SeaGuy/raindance/docs/raindance-spec.docx

# RainDance Sprinkler Controller

This controller will replace the existing broken Intermatic electromechanical sprinkler clock system (240 VAC) using off-the-shelf components.

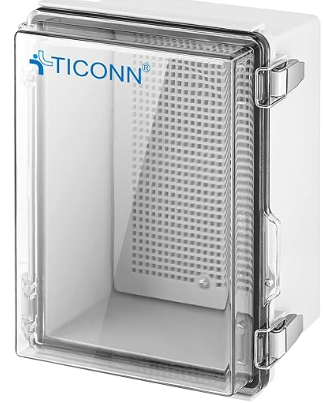
[picture p6: figure]
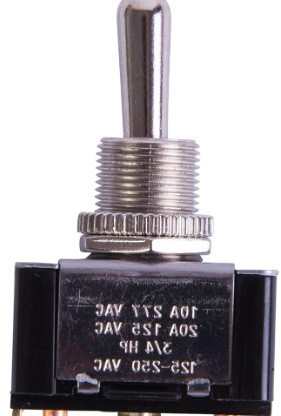
[picture p7: figure]
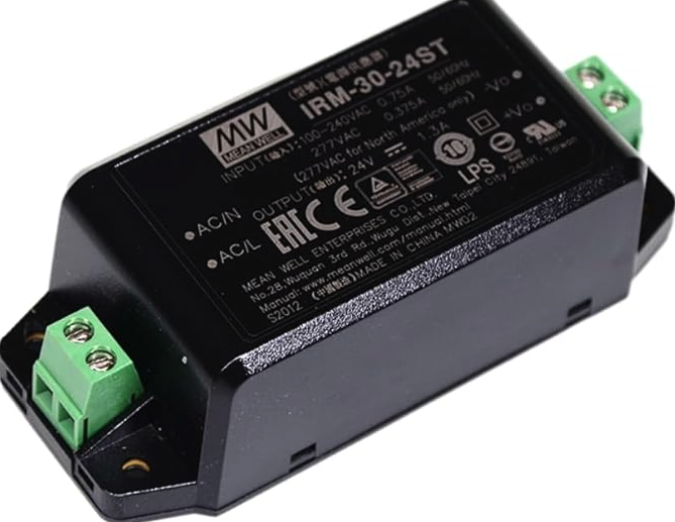
[picture p8: figure]
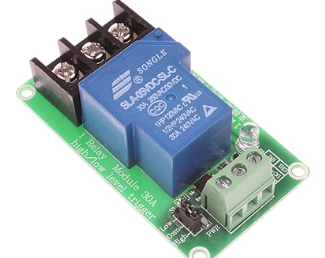
[picture p9: figure]

# Table of Contents

# Hardware Design

XXX

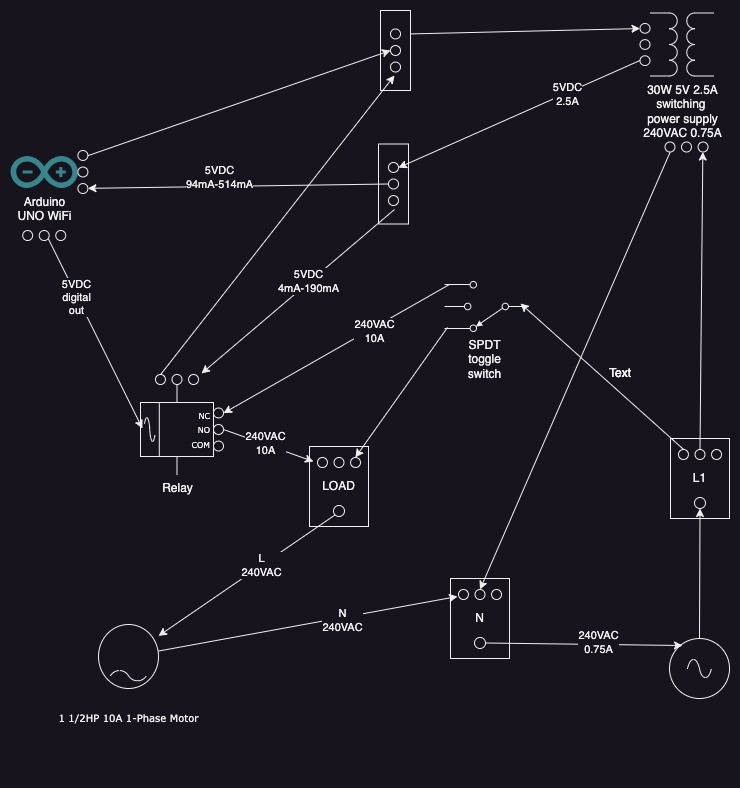
[picture p10: figure]

Power originate from the 240VAC house circuit. A switching power supply makes 5VDC available to the Arduino and relay.

## Relay

The relay (YWBL-WH Relay Module One Way 30A Optocoupler Isolation Relay Module High Power Relay) exhibits the following behavior:

- When powered but NOT energized (no 5VDC control signal is present):
  - COM and NC: closed
  - COM and NO: open
  - NC and NO: open
- When powered and energized (a 5VDC control signal is applied):
  - COM and NC: open
  - COM and NO: closed
  - NC and NO: open

So, the 240VAC should be wired to COM and NO.

## Switching Power Supply

XXX

## 10A Circuit Breaker

Eaton miniature circuit breaker, current-limiting, 10A, 240 VAC / 48 VDC, 1-pole, D

curve, thermal magnetic, 10kA @ 240 VAC interrupting rating, 35mm DIN rail

mount.

## Adafruit Proto Board

Recommend using 22 ga wire

## LEDs

Three LEDs will be used to denote the following conditions:

### Using LEDs on a Breadboard with 5VDC

#### Possible Use Cases

- Waiting for serial port to connect
- Waiting to connect to WiFi

#### Resistor Calculation

To prevent damage to the LEDs, a current-limiting resistor is required. The resistor value can be calculated using Ohm's Law:

R = (VSupply−VLED) / ILED

R = \frac{V_{supply} - V_{LED}}{I_{LED}}R=ILEDVsupply−VLED

Where:

- VsupplyV_{supply}Vsupply = Supply voltage (5V)
- VLEDV_{LED}VLED = Forward voltage of the LED
- ILEDI_{LED}ILED = Desired current through the LED (typically 20mA or 0.02A)

Example Calculation for a Red LED (forward voltage 2V): R=5V−2V0.02A=3V0.02A=150ΩR = \frac{5V - 2V}{0.02A} = \frac{3V}{0.02A} = 150 \OmegaR=0.02A5V−2V=0.02A3V=150Ω

### Recommended LED Types

1. Kingbright WP7113GD (Green, 2.1V, 20mA)
2. Kingbright WP7113ID (Red, 1.85V, 20mA)

# Software Design

XCXX

## iPhone – Arduino Interface

- Use HTTP protocol
- Use GET for ON, OFF, etc.
- Use POST to change parameters (zones, duration, current time, etc.)
- XXX

# Irrigation Pump

The pump is a Pentair Flotec FP5172 1.5 HP Thermoplastic Sprinkler Pump

(https://www.pentair.com/en-us/products/residential/water-supply-disposal/water-supply-pumps/pentair-flotec-fp5172-thermoplastic-sprinkler-pump-1-5-hp.html).

Nameplate Values: 1½ HP; 230 VAC; 9.95A; 1 PH; 60 Hz; 3450RPM

# This is a heading
