SeaGuy/raindance/images/Image 3-18-25 at 1.37 PM.png

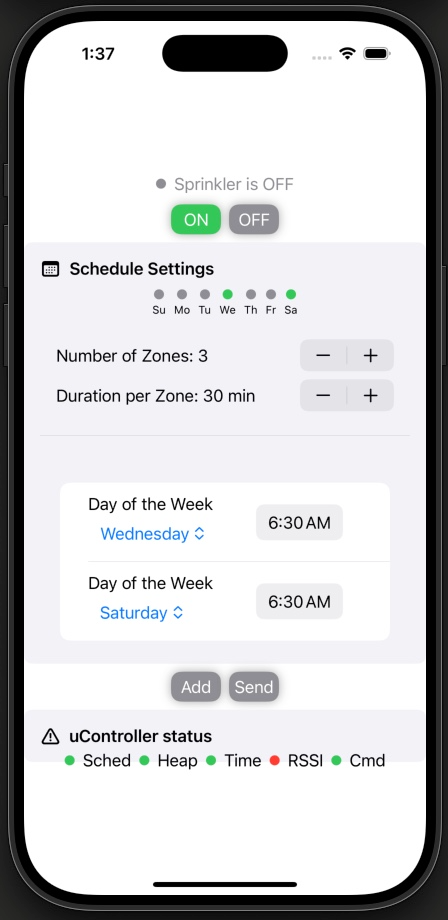
images/Image 3-18-25 at 1.37 PM.png
