SeaGuy/raindance/images/IMG_2071.JPG

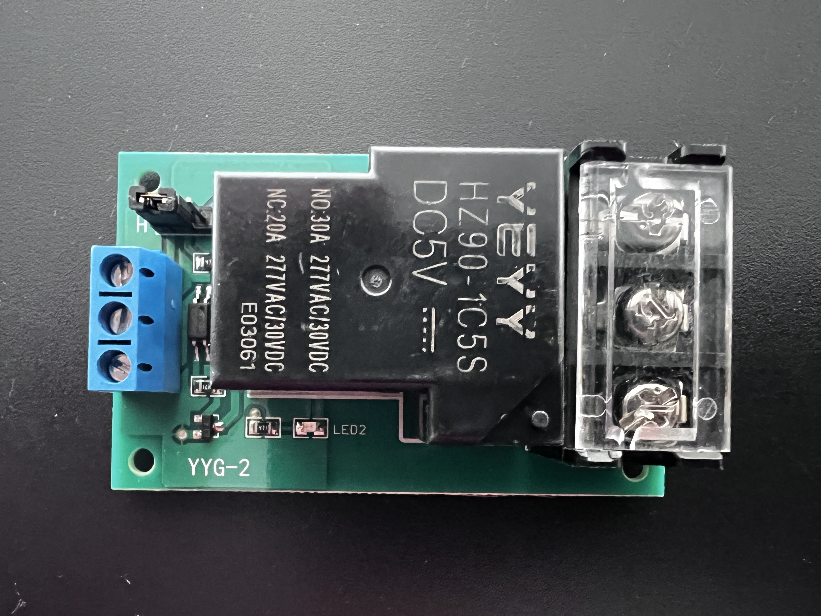
images/IMG_2071.JPG
