SeaGuy/raindance/images/IMG_2072.JPG

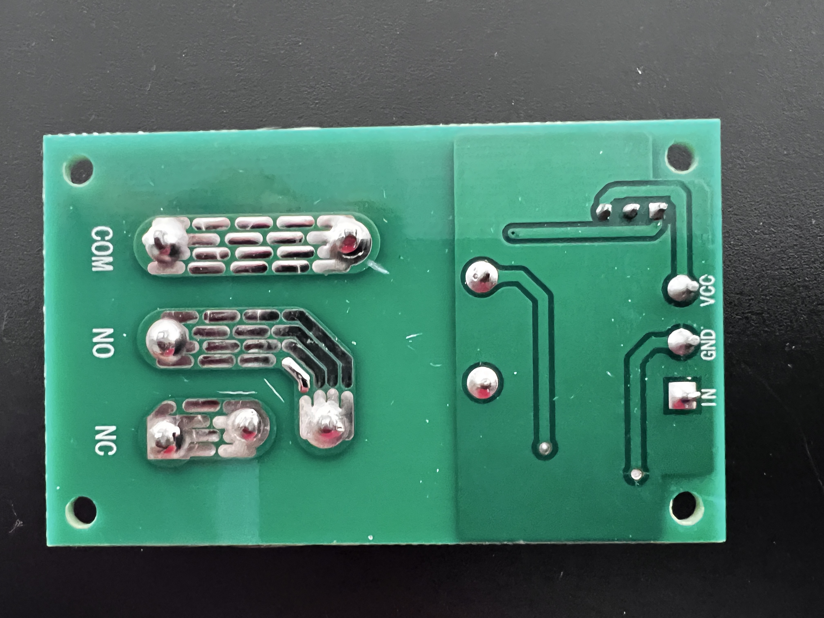
images/IMG_2072.JPG
