SeaGuy/raindance/images/relay-2.jpg

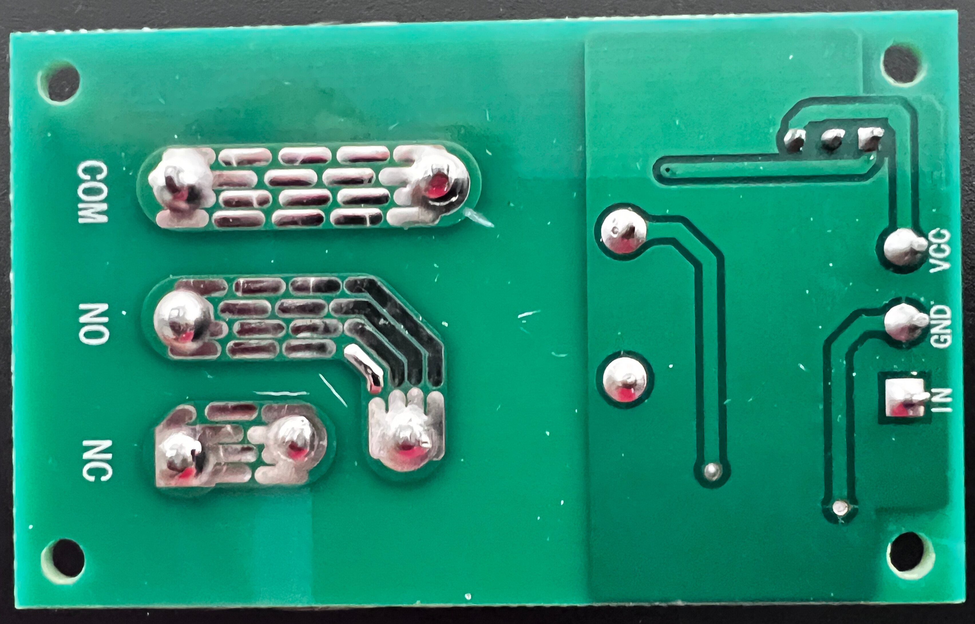
images/relay-2.jpg
