SeaGuy/raindance/bom/bom.xlsx

 |  | Mfr |  | Vendor | Unit
 |  | Part # | Vendor | Part # | Price | Quant
Littlefuse, Inc. | power distribution block | GDB61151Z | DigiKey | GDB61151Z-ND | $22.96 | 3 | $68.88
Qilipsu | IP67 electrical junction box | UL94-V0 | Amazon |  | $30.39 | 1 | $30.39
YWBL-WH | 30A Optocoupler Isolation Relay | YYG-2 | Amazon |  | $8.37 | 1 | $8.37
Arduino | UNO WiFi Rev2 | ABX00021 | Amazon |  | $53.80 | 1 | $53.80
Zhejiang Electronics | SPDT ON-OFF-ON toggle switch | B0CGMKVSZW | Amazon |  | $6.95 | 1 | $6.95
MEALDOO | switching power supply | IRM-30-5ST | Amazon | B0CN6QKC7N | $19.99 | 1 | $19.99
 |  |  |  |  |  |  | $188.38
