SeaGuy/raindance/images/proto-board-wiring-2.jpeg

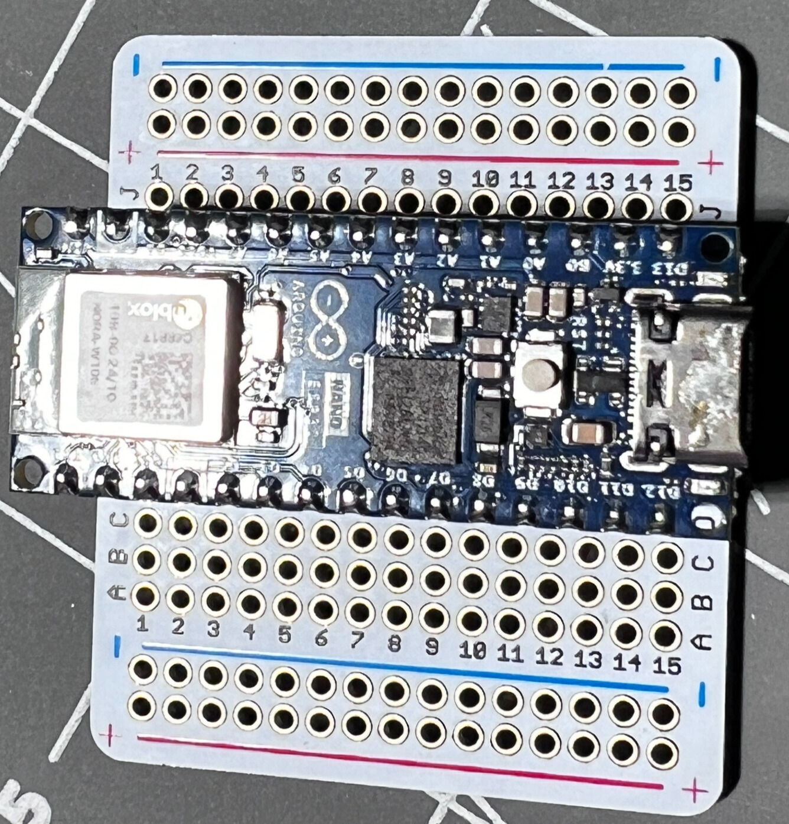
images/proto-board-wiring-2.jpeg
