SeaGuy/raindance/CHANGELOG.md

# Change Log  
All notable changes to this project will be documented in this file.  

First stable release.

The format is based on [Keep a Changelog](http://keepachangelog.com/)  
and this project adheres to [Semantic Versioning](http://semver.org/).  




## [v1.0] - 2024-11-12 ##
### Added ###

- This Changelog
- #ifdef out all println's
- cleaned up README 

### Fixed ###
- No fixes at this time
