SeaGuy/raindance/(commit log)

2024-08-03 added .gitignore and first Arduino sketch to src
2024-08-05 new Arduino sketch and added documentation
2024-08-11 ON and OFF buttons working from iOS XCode iPhone simulator
2024-08-12 got basic I2C communication to the new DS3231 RTC module
2024-08-14 created PrintCurrentTime() function
2024-08-14 added code to get current time from worldtimeapi.org
2024-08-15 added 10A circuit breaker to drawing and doc
2024-08-15 refactored the Arduino sketch using ChatGPT; testing with browser and XCode simulator
2024-08-18 working well with changes to avoid CONNECTION RESET message from Firefox; created a new wiring diagram without physical toggle switch
    [bom.xlsx]
2024-08-19 generalized sendCommand() in SwiftUI; added a HI! command at beginning of iOS app execution to get current Arduino time
2024-08-21 clean up Arduino code
2024-08-21 basic handshaking between app and Arduino for sending the time when year = 1970
2024-08-21 Sprinkler ON LED now working correctly when relay is OFF and ON
    [raindance.ino]
2024-08-22 changed defaults for zones=3 and duration=30 on SwiftUI; changed electrical wiring diagram
2024-08-22 right BEFORE major change to Arduino handleCliemtRequests()
2024-08-22 refactored handleClientRequests() function in Arduino sketch with ChatGPT help
2024-08-28 stable checkpoint: schedule, print schedule
2024-09-09 fixed blinking is on when on schedule
    [raindance.ino]
2024-09-11 fixed getting schedule from EEPROM
    [raindance.ino]
2024-09-16 generalized validateSchedule and baseline before adding day of the week LEDs to SwiftUI code
2024-09-17 stable with new LEDs working
2024-09-20 ChatGPT ported to Arduino sketch from Nano WiFi Rev2 to Nano ESP32; basic ON feature works from iPhone sim; need to look at EEPROM changes
2024-10-10 cleaned up the freeing of timer alarmIDs
2024-10-10 added bitfields and EEPROM map back in even though Nano ESP32 uses flash to emulate EEPROM
2024-10-11 onoffbit not working after adding error value to status response
    [raindance.ino]
2024-10-13 fixed the on-off bit issue and added basic LED support: flash all three colors at startup; green for command receipt; blue for sprinkler on
    [raindance.ino]
2024-10-17 fixed zones decrementer to handle the second schedule and initialze to default
    [raindance.ino]
2024-10-21 simplified blue LED flash x3 for sprinkler on
2024-10-21 simplified LED control
2024-10-28 had to disable WebSockets because the sketch resets when an HTTP GET request arrives from iPhone; running out of patience
    [raindance.ino]
2024-10-28 commented out a lot of Serial.printf
2024-10-29 cleaned up getting validating and printing timestamp; added new status variables for mem, RSSI, sched and timestamp
2024-10-29 added arduino status word and decode into LEDs on SwiftUI
2024-11-12 first release; removed all println with #ifdef DEBUG
2025-01-19 small tweaks; eliminated printing in getScheduleFromEEPROM
2025-01-19 changed iOS app ip address for testing with backup Arduino Nano ESP32
2025-01-20 ChatGPT says some ESP32 boards are sensitive to fast power-ups and recommends adding delay
2025-01-20 enabled more println for debugging
